Esther-365/my-first-hardware-project/Starbie.png

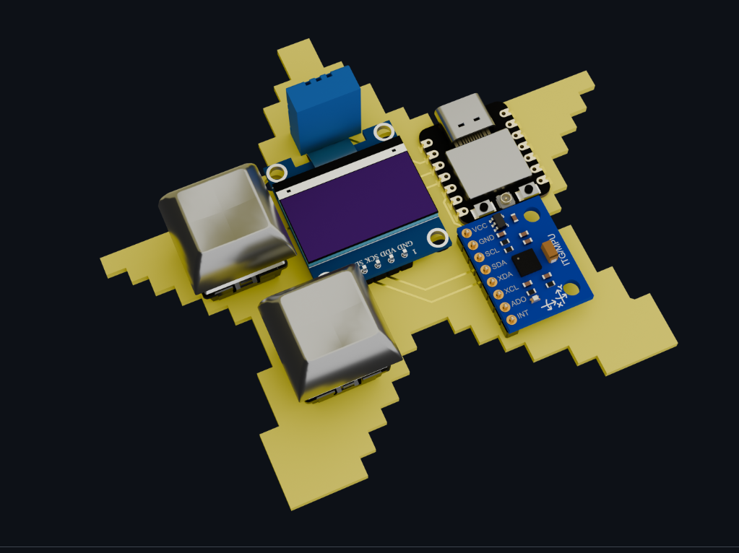
Starbie.png
