Esther-365/my-first-hardware-project/BOM.md

# Starbie – bill of materials

<!-- Generated by Half Life from project cmuvilq5w004901py9rhdkuxq. Edits here are overwritten on the next sync. -->
<!-- Generated: 2026-10-12T03:56:58.020Z -->

> [!NOTE]
> This parts list is mirrored from [Half Life](https://halflife.hackclub.com). Editing it here will not change the platform's copy, and the next sync overwrites this file.

| Week | Tier | Parts funding |
| --- | --- | --- |
| Week 1 | Tier 1 | $30.00 |

| Part | What it's for | Qty | Unit | Total | Vendor |
| --- | --- | --- | --- | --- | --- |
| 10nF Capacitor | — | 1 | $0.00 | $0.00 | C0805C103J5GECTU KEMET | Ceramic Capacitors | DigiKey |
| 100nF Capacitor | — | 1 | $0.00 | $0.00 | Amazon.com: Cizihuu 0805 SMD Ceramic Capacitor, 100nF, Rectangular, 50V, -5°C~+1 |
| 0.96 OLED | — | 4 | $0.00 | $0.00 | https://www.amazon.com/dp/B0GBVWBWCR |
| MPU6050 | — | 1 | $0.00 | $0.00 | https://www.amazon.com/HiLetgo-MPU-6050-Accelerometer-Gyroscope-Converter/dp/B01 |
| JST-PH | — | 10 | $0.00 | $0.00 | B2B-PH-K-S JST Sales America Inc. | Headers, Male Pins | DigiKey |
| 10k Resistor | — | 2 | $0.00 | $0.00 | https://www.amazon.com/dp/B0B4JFPHTW?th=1 |
| MX_switches | — | 6 | $0.00 | $0.00 | https://www.amazon.com//dp/B0FQP8VYX4 |
| XIAO-ESP32-C3-SMD | — | 1 | $0.00 | $0.00 | https://www.seeedstudio.com/Seeed-XIAO-ESP32C3-p-5431.html |
| DHT11 | — | 1 | $0.00 | $0.00 | https://www.amazon.com/dp/B09TKTZMSL/ref=sspa_dk_hqp_detail_aax_0?sp_csd=d2lkZ2V |
| AT42QT1011-TSHR | — | 1 | $0.00 | $0.00 | https://www.digikey.com/en/products/detail/microchip-technology/AT42QT1011-TSHR/ |
| Key Caps | — | 1 | $0.00 | $0.00 | https://www.amazon.com/dp/B0CQ2XG16M?th=1 |
| PCB | — | 1 | $0.00 | $0.00 | https://www.jlcpcb.com/ |
| 200k Resistor | — | 10 | $0.00 | $0.00 | AC0805FR-07200KL YAGEO | Chip Resistor - Surface Mount | DigiKey |
| 100K Resistor | — | 10 | $0.00 | $0.00 | RE0805FRE07100KL YAGEO | Chip Resistor - Surface Mount | DigiKey |
| 150k Resistor | — | 10 | $0.00 | $0.00 | RE0805FRE07150KL YAGEO | Chip Resistor - Surface Mount | DigiKey |
| **Parts subtotal** | — | — | — | **$0.00** | — |
| **Tax & shipping** | — | — | — | **$0.00** | — |
| **Total** | — | — | — | **$0.00** | — |

$30.00 left of the tier's funding.
