Esther-365/my-first-hardware-project/BOM.csv

Item | Qty | Supplier | Cost/item | Total Cost | link
10nF Capacitor | 10 | digikey | $0.04 | $0.40 | https://www.digikey.com/en/products/detail/samsung-electro-mechanics/CL21B103KBANNNC/3886673
100nF Capacitor | 10 | digikey | $0.05 | $0.50 | https://www.digikey.com/en/products/detail/samsung-electro-mechanics/CL21B104KBCNFNC/3888102
0.96 OLED | 1 | Amazon | $5.99 | $5.99 | https://www.amazon.com/dp/B0GBVWBWCR
MPU6050 | 1 | Amazon | $6.99 | $6.99 | https://www.amazon.com/dp/B01DK83ZYQ
JST-PH | 10 | Digikey | $0.10 | $1.00 | https://www.digikey.com/en/products/detail/jst-sales-america-inc/B2B-PH-K-S/926611
10k Resistor | 1 | Digikey | $0.03 | $0.03 | https://www.digikey.com/en/products/detail/stackpole-electronics-inc/RMCF0805FT10K0/1760676
MX_switches | 1 | Amazon | $4.99 | $4.99 | https://www.amazon.com/dp/B0DSHTPSL3
XIAO-ESP32-C3-SMD | 1 | seeed studio | $4.99 | $4.99 | https://www.seeedstudio.com/Seeed-XIAO-ESP32C3-p-5431.html
DHT11 | 1 | Amazon | $5.99 | $5.99 | https://www.amazon.com/dp/B09TKTZMSL/
AT42QT1011-TSHR | 2 | Digikey | $0.77 | $1.54 | https://www.digikey.com/en/products/detail/microchip-technology/AT42QT1011-TSHR/2268868
Key Caps | 1 | Amazon | $4.99 | $4.99 | https://www.amazon.com/dp/B0DBTZFQG1
PCB | 1 | JLCPCB | $10.00 | $10.00 | https://www.jlcpcb.com/
200k Resistor | 10 | Digikey | $0.09 | $0.90 | https://www.digikey.com/en/products/detail/panasonic-industry/ERA-6AEB204V/1465804
100K Resistor | 10 | DigiKey | $0.03 | $0.30 | https://www.digikey.com/en/products/detail/yageo/RC0805JR-07100KL/728239
150k Resistor | 10 | DigiKey | $0.02 | $0.20 | https://www.digikey.com/en/products/detail/yageo/RT0805FRE07150KL/1078969
1000mAh battery | 1 | Amazon | $7.79 | $7.79 | https://www.amazon.com/dp/B0GHR5J34D
M2.5 | 1 | Amazon | $9.99 | $9.99 | https://www.amazon.com/dp/B0FG2BYJSR
Fabric-over-foam gasket | 1 | DigiKey | $11.30 | $11.30 | https://www.digikey.com/en/products/detail/laird-technologies-emi/4216PA51H01800/2350543
40-pin female header strip | 1 | Digikey | $1.39 | $1.39 | https://www.digikey.com/en/products/detail/chip-quik-inc/HDR100IMP40F-G-V-TH/5978200
Estimated total shipping | 1 |  |  | $10.00
