Esther-365/my-first-hardware-project/newBOM.csv

Part | QTY | Unit | Total | Vendor
10nF Capacitor | 1 | 0.38 | 0.38 | C0805C103J5GECTU KEMET | Ceramic Capacitors | DigiKey
100nF Capacitor | 1 | 4.74 | 4.74 | Amazon.com: Cizihuu 0805 SMD Ceramic Capacitor, 100nF, Rectangular, 50V, -5°C~+125°C, 200pcs : Industrial & Scientific
0.96 OLED | 4 | 5.99 | 9.99 | https://www.amazon.com/dp/B0GBVWBWCR
MPU6050 | 1 | 6.99 | 6.99 | https://www.amazon.com/HiLetgo-MPU-6050-Accelerometer-Gyroscope-Converter/dp/B01DK83ZYQ?s=industrial
JST-PH | 10 | 0.12 | 1 | B2B-PH-K-S JST Sales America Inc. | Headers, Male Pins | DigiKey
10k Resistor | 2 | 4.97 | 9.94 | https://www.amazon.com/dp/B0B4JFPHTW?th=1
MX_switches | 6 | 0.18 | 1.08 | https://www.amazon.com//dp/B0FQP8VYX4
XIAO-ESP32-C3-SMD | 1 | 4.99 | 4.99 | https://www.seeedstudio.com/Seeed-XIAO-ESP32C3-p-5431.html
DHT11 | 1 | 5.99 | 5.99 | https://www.amazon.com/dp/B09TKTZMSL?sp_csd=d2lkZ2V0TmFtZT1zcF9ocXBfc2hhcmVk
AT42QT1011-TSHR | 1 | 0.77 | 1.54 | https://www.digikey.com/en/products/detail/microchip-technology/AT42QT1011-TSHR/2268868
Key Caps | 1 | 11.99 | 11.99 | https://www.amazon.com/dp/B0CQ2XG16M?th=1
PCB | 1 | 10 | 10 | https://www.jlcpcb.com/
200k Resistor | 10 | 0.1 | 0.38 | AC0805FR-07200KL YAGEO | Chip Resistor - Surface Mount | DigiKey
100K Resistor | 10 | 0.15 | 0.72 | RE0805FRE07100KL YAGEO | Chip Resistor - Surface Mount | DigiKey
150k Resistor | 10 | 0.15 | 0.72 | RE0805FRE07150KL YAGEO | Chip Resistor - Surface Mount | DigiKey
1000mAh battery | 1 | 7.99 | 7.99 | https://www.ebay.com/itm/174819689504?chn=ps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
M2.5 | 1 | 9.99 | 9.99 | https://www.amazon.com/sspa/click
M3 | 1 | 8.99 | 9.99 | https://www.amazon.com/sspa/click
Fabric-over-foam gasket | 1 | 16.55 | 16.55 | https://www.newark.com/wurth-elektronik/3021008/emi-shielding-1m-x-10mm-x-8mm/dp/58T7176
40-pin female header strip | 1 | 1.95 | 1.95 | https://www.sparkfun.com/straight-header-female-pth-0-1in-40-pin.html
