Esther-365/my-first-hardware-project/Assembly 1.step

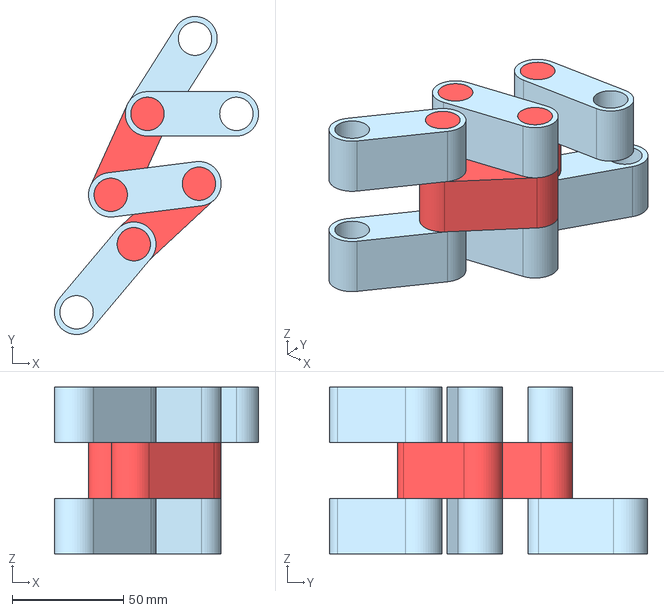
[picture p4: CAD file, 2026-10-18]
Assembly 1.step
91.9 x 143.1 x 75.0 mm
