Esther-365/my-first-hardware-project/Part Studio 1.step

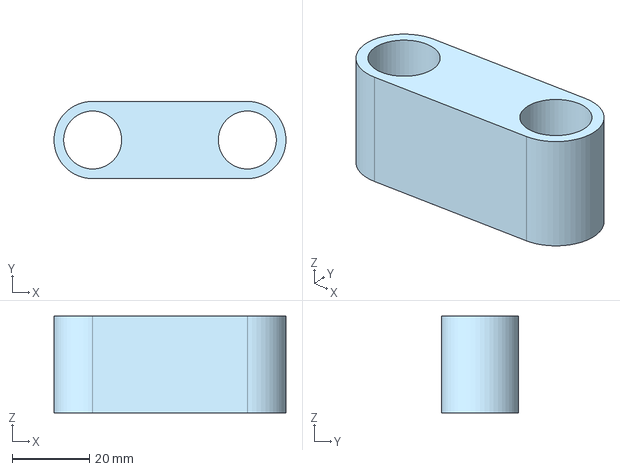
[picture p5: CAD file, 2026-10-18]
Part Studio 1.step
60.0 x 20.0 x 25.0 mm
