Esther-365/my-first-hardware-project/Switch case.step

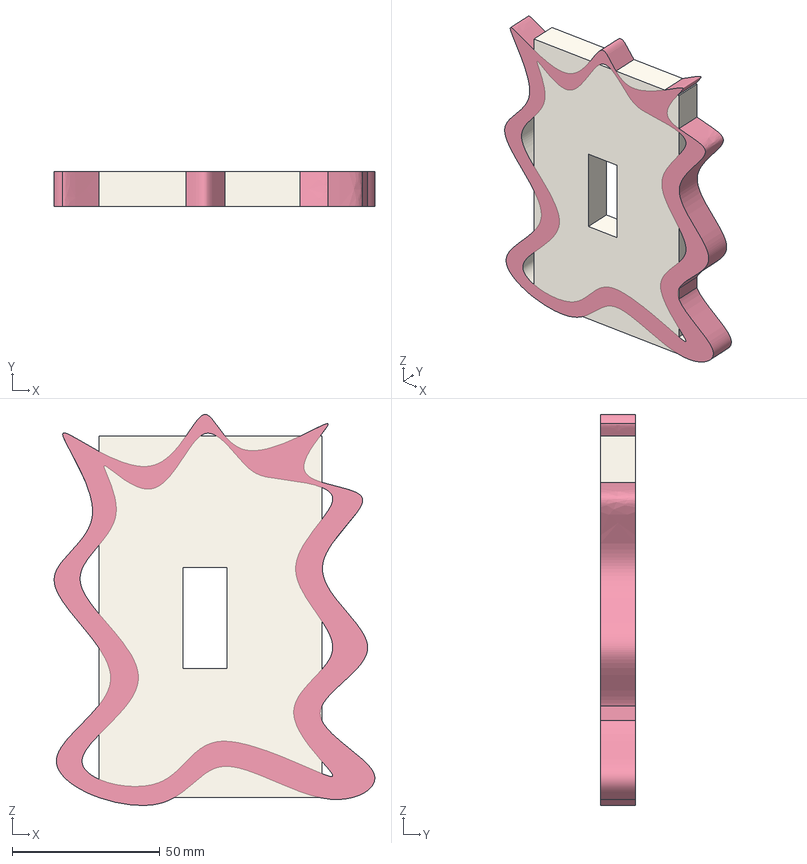
[picture p6: CAD file, 2026-10-18]
Switch case.step
108.7 x 12.0 x 132.5 mm
