Esther-365/my-first-hardware-project/Inverted cup.step

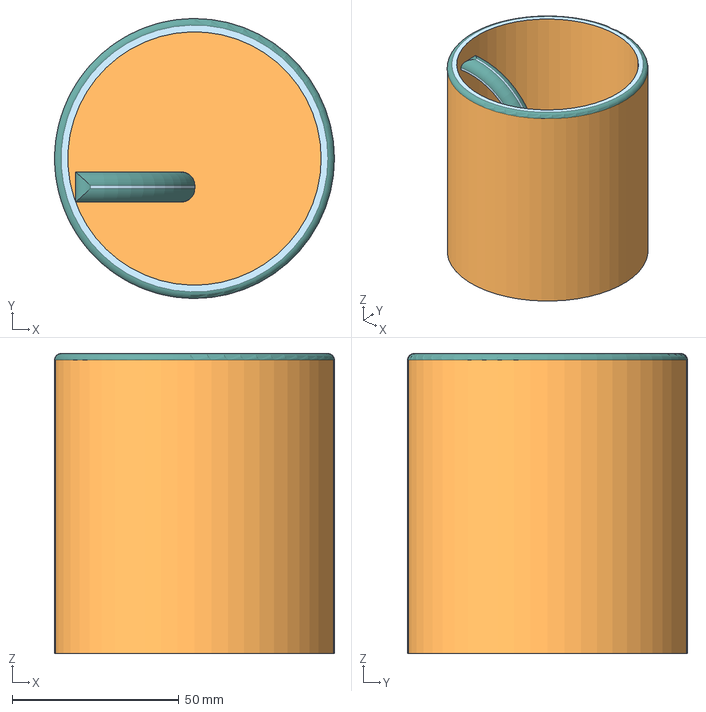
[picture p7: CAD file, 2026-10-18]
Inverted cup.step
84.0 x 84.0 x 90.0 mm
