Esther-365/my-first-hardware-project/Digital_pet_starbie (1).step

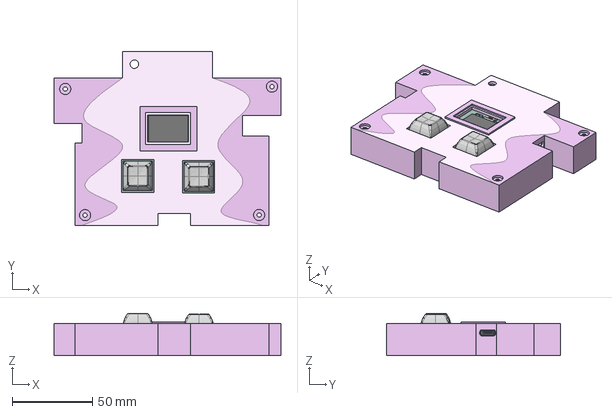
[picture p8: CAD file, 2026-10-18]
Digital_pet_starbie (1).step
141.2 x 108.2 x 26.3 mm
