Esther-365/my-first-hardware-project/Part Studio 1 Copy 1.step

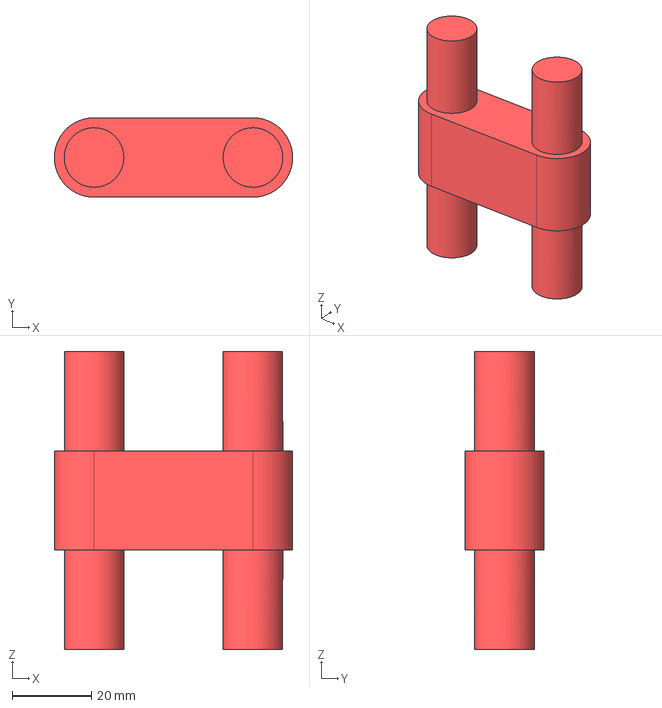
[picture p9: CAD file, 2026-10-18, an earlier design]
Part Studio 1 Copy 1.step
60.0 x 20.0 x 75.0 mm
