Esther-365/my-first-hardware-project/(list of files, cad)

Other CAD files:
Digital_pet_starbie.stl
