Esther-365/my-first-hardware-project/midi_gangan.kicad_pcb

## KiCad design midi_gangan.kicad_pcb (2026-10-26)

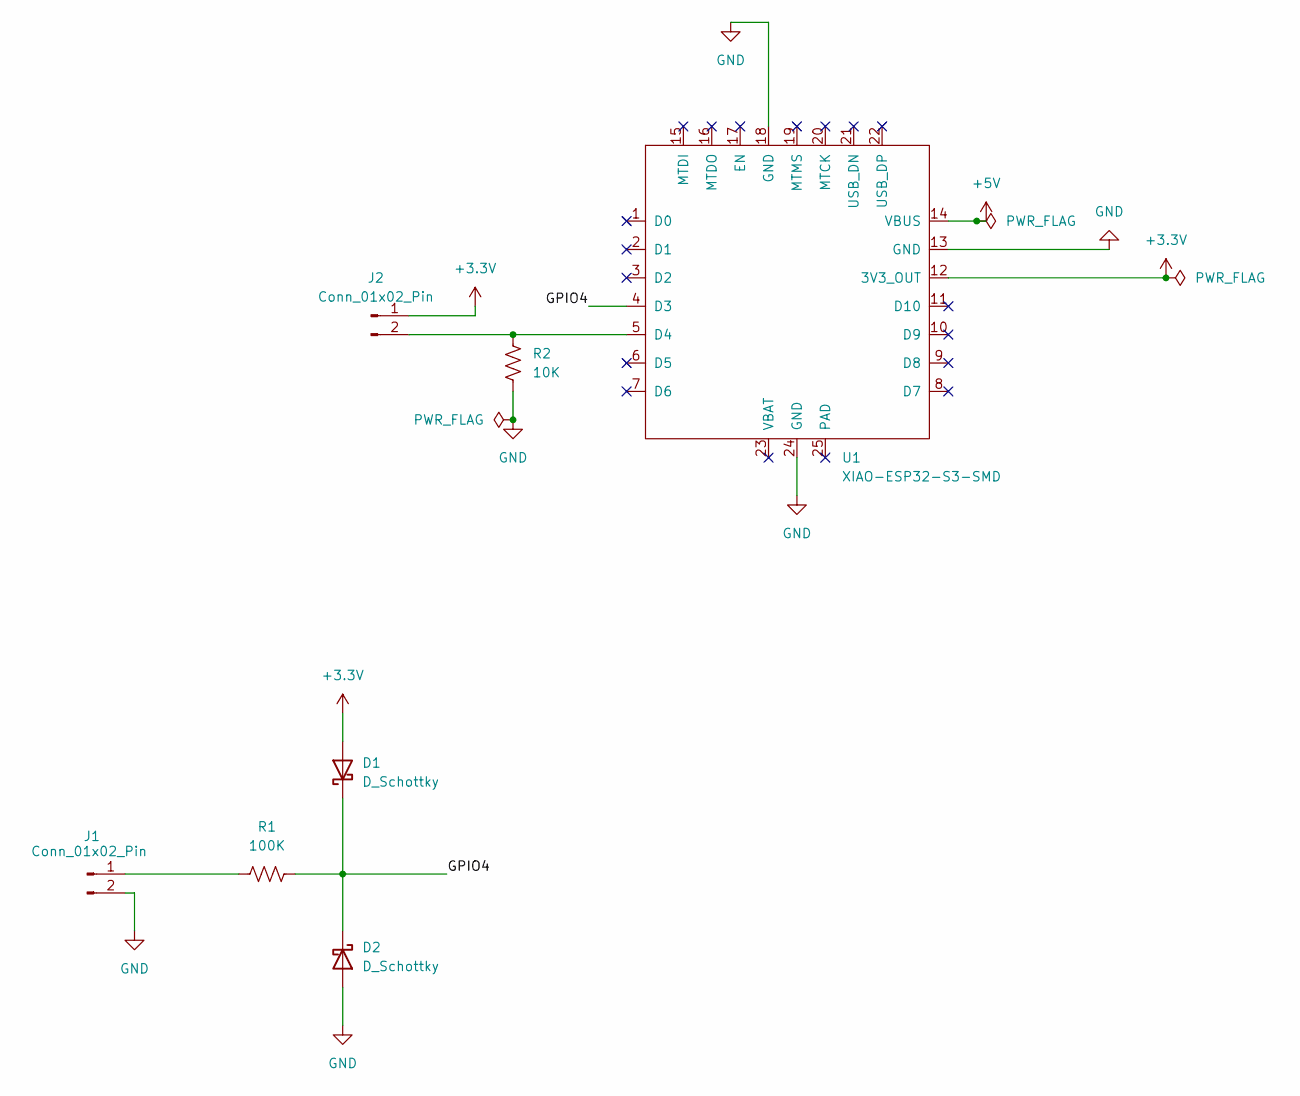
[picture p10: schematic midi_gangan.kicad_sch]

Parts:
D1, D2: D_Schottky; D_SOD-123F
J1, J2: Conn_01x02_Pin; TerminalBlock_Phoenix_MKDS-1,5-2_1x02_P5.00mm_Horizontal
R1: 100K; R_0805_2012Metric
R2: 10K; R_0805_2012Metric
U1: XIAO-ESP32-S3-SMD

Connections:
+3.3V: D1.2 (A), J2.1, U1.12 (3V3_OUT)
+5V: U1.14 (VBUS)
/GPIO4: D1.1 (K), D2.1 (K), R1.2, U1.4 (D3)
GND: D2.2 (A), J1.2, R2.2, U1.13 (GND), U1.18 (GND), U1.24 (GND)
unnamed: J1.1, R1.1
unnamed: J2.2, R2.1, U1.5 (D4)

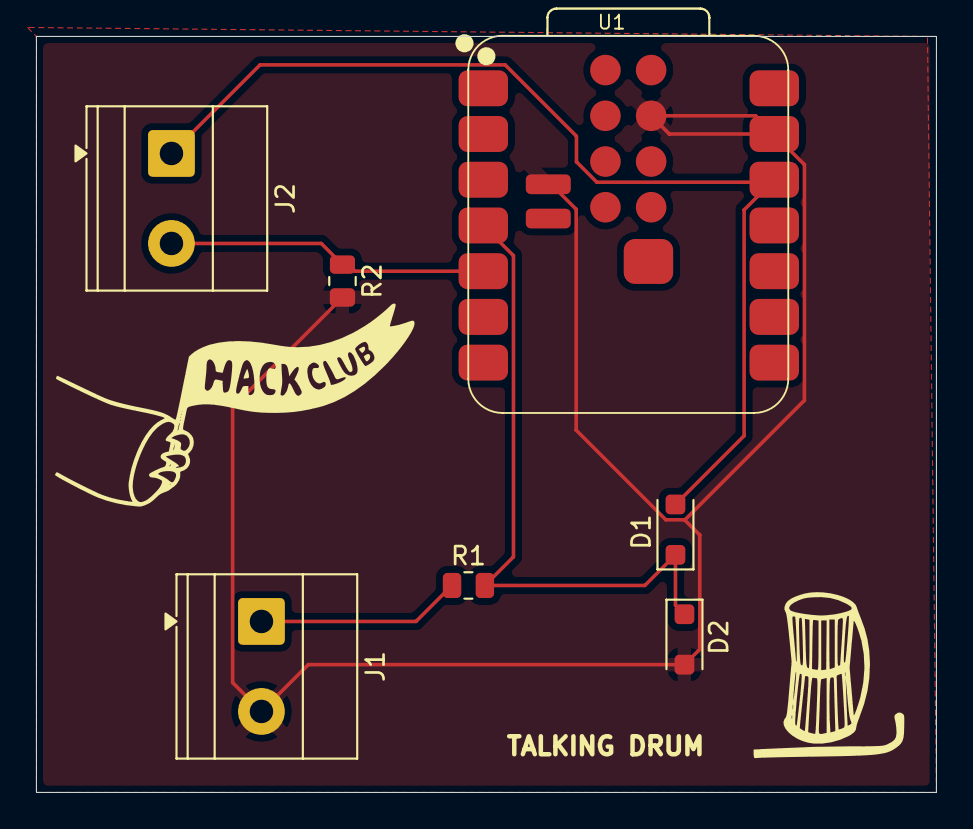
[picture p11: board midi_gangan.kicad_pcb from above]

Board: 2 copper layers, 50.0 x 42.0 mm, 7 parts (0 on the bottom side), 5 nets.
