Esther-365/my-first-hardware-project/Digital_pet_starbie.kicad_pcb

## KiCad design Digital_pet_starbie.kicad_pcb (2026-10-12)

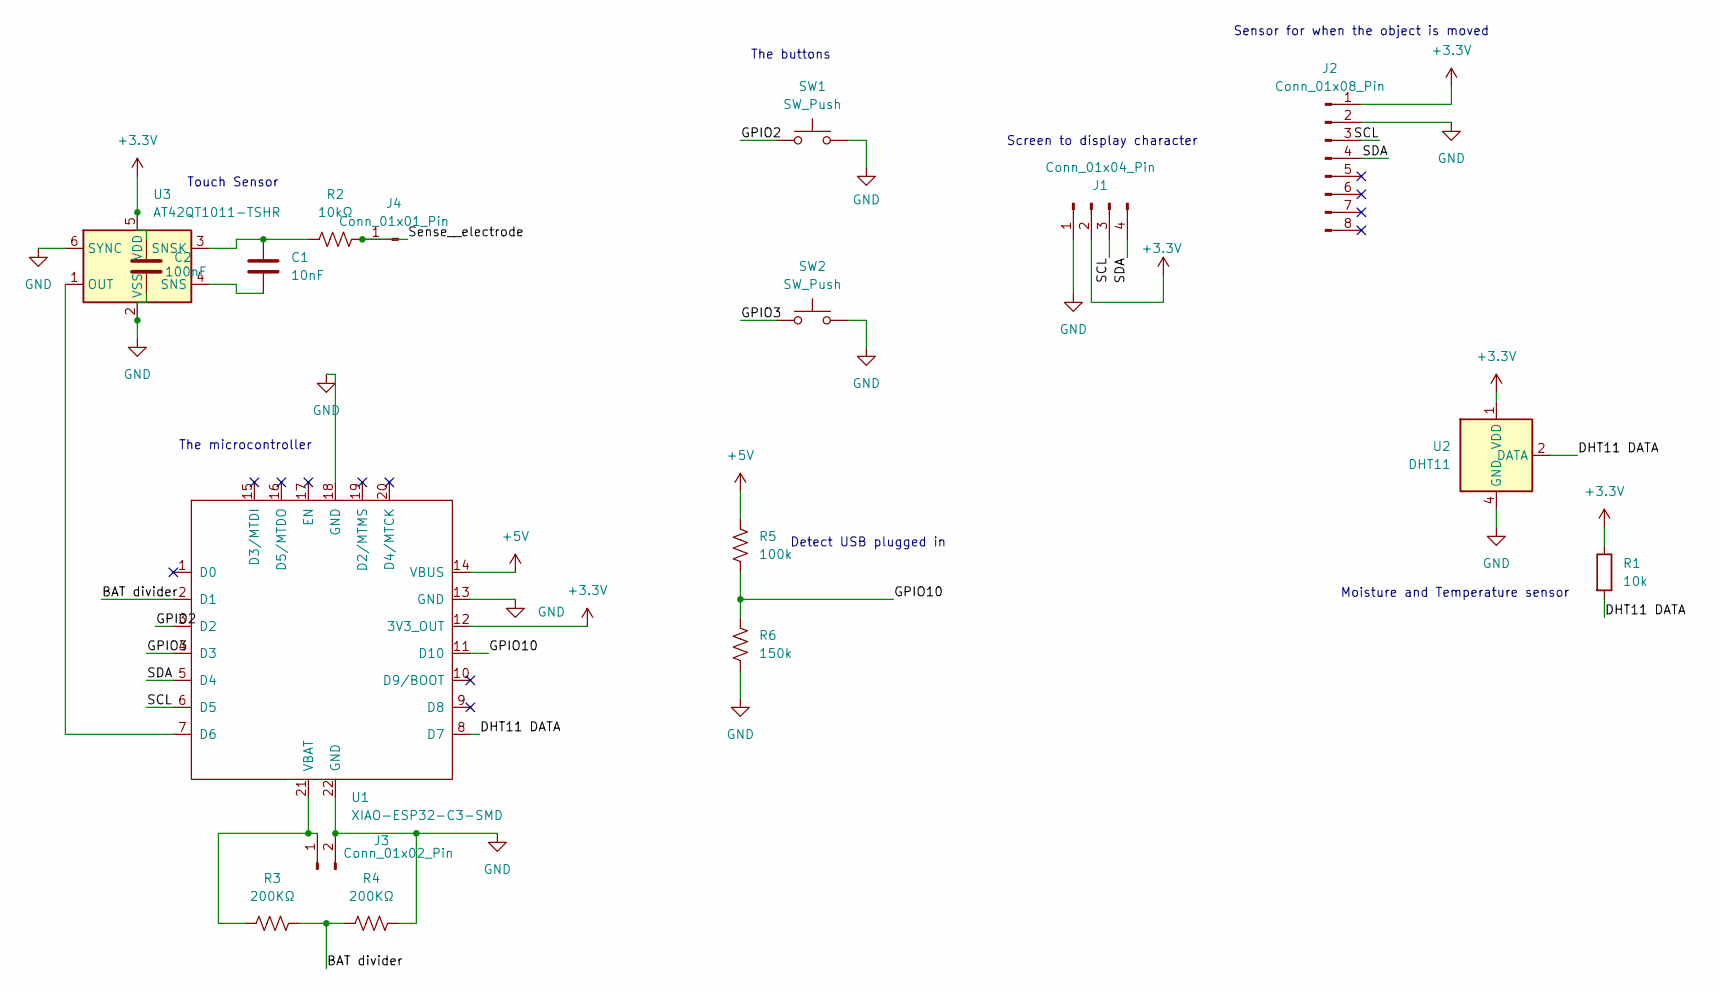
[picture p12: schematic Digital_pet_starbie.kicad_sch]

Parts:
C1: 10nF; C_0805_2012Metric_Pad1.18x1.45mm_HandSolder
C2: 100nF; C_0805_2012Metric_Pad1.18x1.45mm_HandSolder
J1: Conn_01x04_Pin; Display_128x64_096_I2C
J2: Conn_01x08_Pin; PinHeader_1x08_P2.54mm_Vertical
J3: Conn_01x02_Pin; JST_PH_B2B-PH-K_1x02_P2.00mm_Vertical
J4: Conn_01x01_Pin; Touch_electrode
R1: 10k; R_Axial_DIN0204_L3.6mm_D1.6mm_P7.62mm_Horizontal
R2: 10kΩ; R_0805_2012Metric_Pad1.20x1.40mm_HandSolder
R3, R4: 200KΩ; R_0805_2012Metric_Pad1.20x1.40mm_HandSolder
R5: 100k; R_0805_2012Metric_Pad1.20x1.40mm_HandSolder
R6: 150k; R_0805_2012Metric_Pad1.20x1.40mm_HandSolder
SW1, SW2: SW_Push; SW_Cherry_MX_1.00u_PCB
U1: XIAO-ESP32-C3-SMD
U2: DHT11; Aosong_DHT11_5.5x12.0_P2.54mm
U3: AT42QT1011-TSHR; SOT-23-6_Handsoldering

Connections:
+3.3V: C2.1, J1.2, J2.1, R1.1, U1.12 (3V3_OUT), U2.1 (VDD), U3.5 (VDD)
+5V: R5.2, U1.14 (VBUS)
/BAT divider: R3.2, R4.1, U1.2 (D1)
/DHT11 DATA: R1.2, U1.8 (D7), U2.2 (DATA)
/GPIO2: SW1.1, U1.3 (D2)
/GPIO3: SW2.1, U1.4 (D3)
/GPIO10: R5.1, R6.2, U1.11 (D10)
/SCL: J1.3, J2.3, U1.6 (D5)
/SDA: J1.4, J2.4, U1.5 (D4)
/Sense__electrode: J4.1 (Pin_1_1), R2.2
GND: C2.2, J1.1, J2.2, J3.2, R4.2, R6.1, SW1.2, SW2.2, U1.13 (GND), U1.18 (GND), U1.22 (GND), U2.4 (GND), U3.2 (VSS), U3.6 (SYNC)
unnamed: J3.1, R3.1, U1.21 (VBAT)
unnamed: U1.7 (D6), U3.1 (OUT)
unnamed: C1.2, U3.4 (SNS)
unnamed: C1.1, R2.1, U3.3 (SNSK)

Notes on the sheet:
The buttons
The microcontroller
Screen to display character
Sensor for when the object is moved
Moisture and Temperature sensor
Touch Sensor
Detect USB plugged in

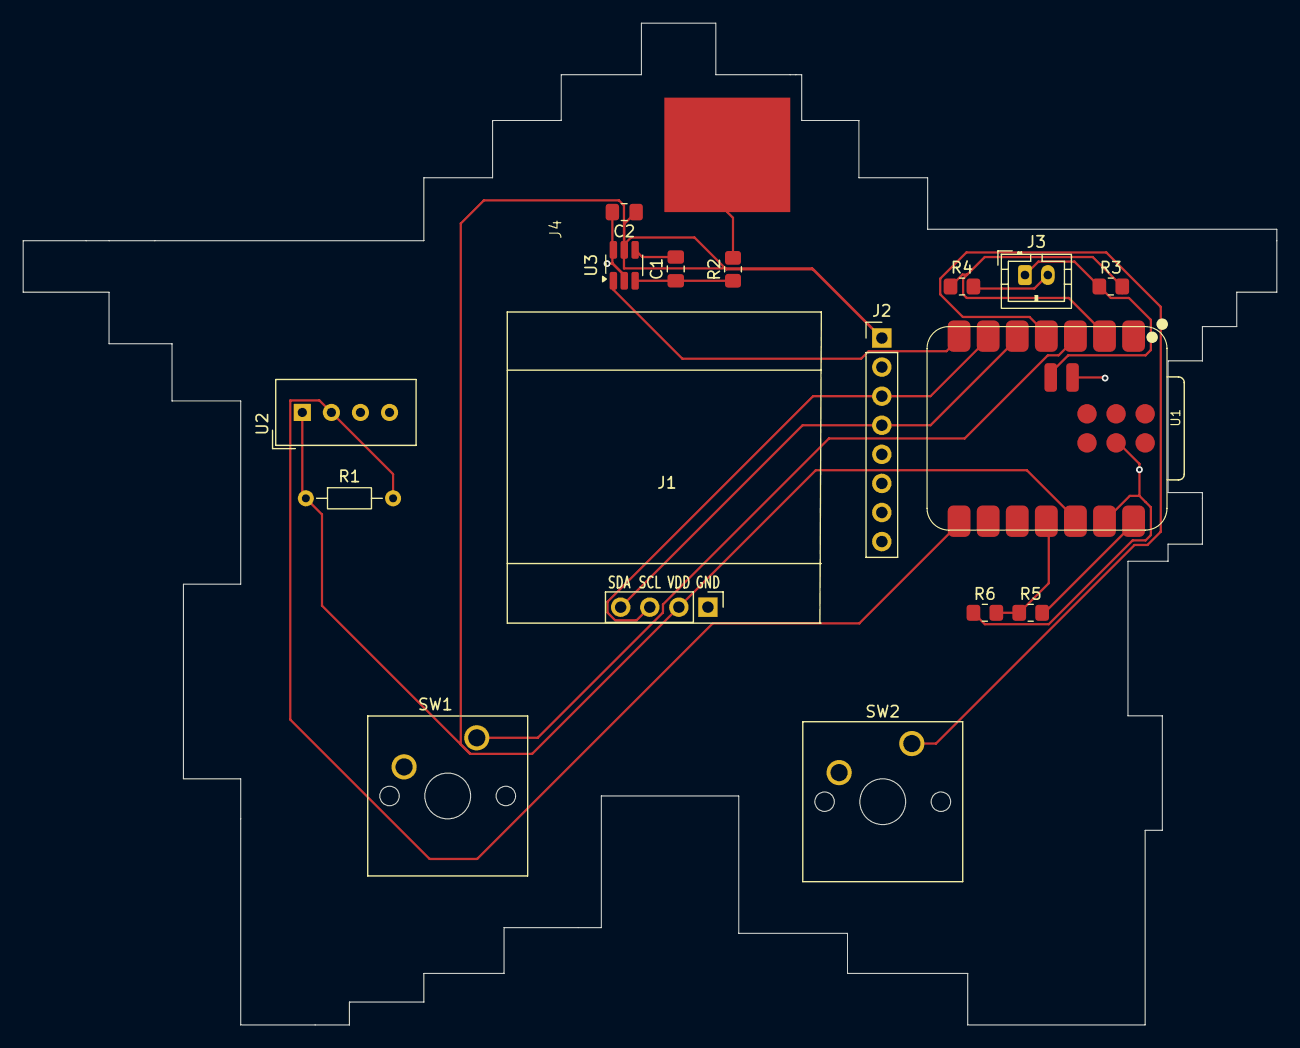
[picture p13: board Digital_pet_starbie.kicad_pcb from above]

Board: 2 copper layers, 109.5 x 87.5 mm, 17 parts (0 on the bottom side), 15 nets.
