Esther-365/my-first-hardware-project/(commit log)

2026-10-12 The pcb file
2026-10-12 KiCad Schematic file
2026-10-12 The gerbers file in Zip format
2026-10-12 Arduino IDE
2026-10-12 Added BOM.csv again
2026-10-18 Uploaded .stl and .step file of PCB 3D enclosure
2026-10-25 Add enclosure image to README
2026-10-25 Enhance README with controls and BOM details
    Added controls section and BOM table to README.
